wtywtykk/Inverter_MS2017/(list of files, drawings)

Other design files:
MSSch/FAN7390.PcbLib
MSSch/FAN7390.SchLib
MSSch/MSSch.PrjPcb
MSSch/MSSch.SchDoc
